msecci/Esp32_WROOM_MQTT_Terrario/documentazione/Progetto Terrario Evoluto.odt

Terrario Evoluto

Un ecosistema controllato con illuminazione intelligente

# Introduzione

Il presente documento contiene dettagli su un coperchio per terrario di ultima generazione che combina tecnologia avanzata e praticità per offrire un ambiente ottimale alle piante. Questo innovativo coperchio è dotato di un sistema di illuminazione a LED, pilotato dal modulo ESP32, che consente di gestire diverse gradazioni di luminosità. Oltre a garantire un'illuminazione personalizzabile, il coperchio è equipaggiato con sensori in grado di rilevare la temperatura e l'umidità del terrario.

Grazie alla possibilità di programmare gli accensioni e gli spegnimenti, e di regolare la luminosità in base alla luce ambientale attraverso la selezione di scenari, il coperchio assicura il mantenimento di parametri ambientali con un controllo accurato. Tutti i parametri rilevati vengono visualizzati su un display, offrendo una lettura chiara e immediata delle condizioni ambientali del terrario.

La gestione remota è resa possibile attraverso un'app dedicata, che permette di monitorare e modificare le impostazioni direttamente da smartphone o tablet. Questo coperchio per terrario rappresenta la soluzione ideale per chi desidera un ambiente controllato e perfettamente adattabile alle esigenze delle proprie piante.

# Descrizione

Il progetto prevede la realizzazione di un terrario chiuso, un sistema in grado di replicare e mantenere un microambiente autonomo e controllato. Il terrario è dotato di un tappo speciale che ospita tutta l’elettronica necessaria per la gestione dell’illuminazione e del monitoraggio ambientale. L’obiettivo è fornire un ambiente ideale per lo sviluppo di piante simulando condizioni climatiche naturali con un livello di automazione elevato. In caso di superamento della soglia critica di temperatura, il sistema spegnerà i led richiedendo il ripristino manuale.

# Obiettivo

L’idea nasce dalla necessità di creare un ecosistema autosufficiente che permetta agli utenti di osservare e interagire con un ambiente naturale controllato. Il sistema offre un’illuminazione regolabile, il monitoraggio dei parametri ambientali e la possibilità di gestione remota tramite un’app dedicata. Grazie alle diverse modalità di funzionamento e alle connessioni disponibili, il terrario garantisce una grande versatilità e facilità d’uso.

# Specifiche Tecniche

## Componenti principali

- Terrario chiuso, progettato per mantenere condizioni ambientali stabili.
- Sistema di illuminazione LED composto da tre LED di colori differenti (bianco, rosso e blu), selezionati per ottimizzare la crescita delle piante e migliorare l’effetto estetico.
- Display da 2" per visualizzare le informazioni ambientali in tempo reale.
- Sensori integrati che misurano temperatura, umidità e luminosità.
- Modulo Bluetooth e Wi-Fi per la gestione e il controllo remoto.
- App dedicata per interagire con il sistema attraverso connessione locale (Bluetooth) o remota (Internet).

## Modalità operative

- Stand-alone; il sistema funziona autonomamente senza bisogno di connessione a dispositivi esterni. I parametri sono gestiti con 3 pulsanti.
- Internet: consente la gestione remota e l’accesso a informazioni aggiuntive, come data, ora e previsioni meteo settimanali.

## Tecnologia utilizzata

- Microcontrollore ESP32-C3.
- Display Oled 2”.
- Darling per pilotaggio LED TIP120.
- Sensore temperatura e umidità DHT11.
- Sensore luminosità: fotoresistenza.
- Led bianco, rosso e blu da 3W.
- Pulsanti per la gestione delle funzioni in locale.
- Protocollo bluetooth per gestione delle funzioni senza connessione a internet.
- Protocollo MQTT per la gestione remota attraverso app.

# Funzionalità e innovazione

## Gestione dell’illuminazione

Il sistema di illuminazione è progettato per adattarsi alle esigenze del microambiente interno. I LED possono essere regolati automaticamente in base alla luce ambientale presente: se l’illuminazione naturale è sufficiente, il sistema evita di accendere i LED, ottimizzando il consumo energetico. Gli scenari disponibili sono:

- Tropicale: simula un ambiente caldo e umido con illuminazione intensa.
- Temperato: riproduce un clima moderato con illuminazione equilibrata.
- Soleggiato: simula una giornata luminosa con esposizione solare diretta.
- Scenario Custom: Permette all’utente di definire manualmente l’intensità e la durata dell’illuminazione.

Inoltre, il sistema integra un timer che regola la durata di accensione dei LED in base allo scenario selezionato, garantendo un ciclo di illuminazione coerente con le esigenze dell’ambiente interno.

## Monitoraggio ambientale avanzato

Il terrario evoluto non si limita alla regolazione della luce, ma offre anche un monitoraggio completo delle condizioni ambientali:

- Temperatura e umidità: misurati costantemente dai sensori per garantire il controllo delle condizioni ottimali.
- Luminosità: valutata per ottimizzare l’accensione dei LED.
- Visualizzazione su display: tutti i dati raccolti vengono mostrati in tempo reale sul display da 2".
- Previsioni meteo: se connesso a internet, il sistema mostra dati meteorologici aggiornati, incluse le previsioni per i prossimi 7 giorni. I dati meteo sono basati sulle coordinate ricavate dalla geolocalizzazione della connessione internet. La data e all’ora sono sincronizzate sul un server NTP. Le previsioni meteo saranno

## Interazione e connettività

Il sistema offre tre modalità operative, garantendo una grande flessibilità:

- Modalità Stand-alone: il terrario funziona autonomamente senza necessità di connessione.
- Modalità Internet: permette il controllo remoto e l’accesso a informazioni esterne, come data, ora e previsioni meteorologiche.

# Applicazioni e utilizzi

Il progetto offre numerose applicazioni pratiche, sia per il settore scientifico che per l’uso personale:

- Educazione e didattica: ideale per lo studio ed esperimenti sulla gestione di ecosistemi chiusi.
- Decorazione e hobby: un oggetto innovativo per appassionati di natura e tecnologia, perfetto per ambienti domestici e lavorativi.

# Presentazione per Maker Faire

Per la presentazione del progetto alla Maker Faire 2025, saranno preparati i seguenti materiali:

- Prototipo funzionante per una dimostrazione pratica dal vivo.
- Video esplicativo che illustra il funzionamento del sistema.
- Brochure informativa con dettagli tecnici e descrizione del progetto.

### Titolo del Progetto: Terrar0 Evoluto – Ecosistema Autonomo e Interattivo

#### Descrizione del Progetto:

Il Terrario Evoluto è un ecosistema chiuso e autosufficiente dotato di tecnologia avanzata per garantire il monitoraggio e la gestione ottimale dell’ambiente interno. Il sistema integra un tappo intelligente che fornisce illuminazione tramite LED, controlla i parametri ambientali (temperatura, umidità, illuminazione), gestisce scenari di funzionamento personalizzati e si interfaccia con un'app per il controllo remoto. Inoltre, il dispositivo è equipaggiato con un display che mostra in tempo reale i parametri ambientali e fornisce previsioni meteo, rendendo il terrario un vero e proprio punto di connessione tra natura e tecnologia.

#### Utilizzo e Destinatari:

Il errario Evoluto è pensato per appassionati di botanica, tecnologia e design, oltre che per chi desidera avere un piccolo ecosistema autosufficiente in casa, in ufficio o in ambienti didattici. Il sistema consente di osservare e interagire con un habitat naturale senza interventi quotidiani, offrendo un'esperienza educativa e decorativa allo stesso tempo.

#### Impatto del Progetto:

Grazie all’integrazione tra natura e tecnologia, il errario Evoluto rappresenta una soluzione innovativa per chi desidera avvicinarsi al mondo della coltivazione automatizzata e del monitoraggio ambientale. La possibilità di visualizzare previsioni meteo e parametri in tempo reale su un display facilita la gestione dell’ecosistema, aumentando la consapevolezza sui fattori ambientali. Il progetto ha il potenziale di diffondersi nel settore dell’interior design, della didattica e della smart home.

#### Motivazioni per Avere uno Stand a Maker Faire Rome:

Maker Faire Rome è l’evento ideale per presentare il errario Evoluto, poiché unisce innovazione, tecnologia e sostenibilità. Esporre il progetto permetterebbe ai visitatori di osservare dal vivo il funzionamento dell’ecosistema, testare le sue funzionalità interattive e comprenderne l’applicazione in diversi contesti. La sua combinazione di elettronica, software e biologia lo rende un esempio perfetto di interdisciplinarità, rispecchiando lo spirito dell'evento.

#### Stato Attuale dello Sviluppo e Prodotto Finale:

Il progetto è attualmente in fase di messa a punto del software. L’obiettivo è migliorare l’integrazione tra sensori e l’app, perfezionare il design del display per rendere la visualizzazione più fluida. Se selezionato, il errario Evoluto sarà presentato come una versione completamente funzionale, con un’interfaccia ottimizzata e la possibilità di interazione diretta con il pubblico.

Parlami di te

Ho realizzato progetti di home automation a livello hobbistico, basati sull'utilizzo di microcontrollori e app di controllo gestite con il protocollo mqtt.

Sono ingegnere informatico e nella vita lavorativa mi occupo di coordinare un gruppo di persone che si occupano dello sviluppo di applicazioni e della gestione di infrastrutture virtuali.

Nel tempo libero ho sempre coltivato la passione per lo sviluppo di progetti elettronici e sviluppo di software in generale.

Inoltre sono appassionato di retrocomputing del periodo anni 80-90.
