msecci/Esp32_WROOM_MQTT_Terrario/documentazione/video.odt

Testo per la presentazione alla Call di Maker Faire

# Versione 1 del testo per video

🎙️ VOCE NARRANTE (tono pacato, affascinato):

Musica leggera e suggestiva in sottofondo. Inquadratura iniziale su una mensola, luce naturale, diversi barattoli di vetro in primo piano.

"In un angolo silenzioso del nostro mondo moderno, esiste un ecosistema in miniatura.
Chiuso in un semplice barattolo di vetro, grande quanto una mano...
vive un frammento di natura, autosufficiente e sorprendentemente vivo."

Ripresa lenta e fluida, dolly in avanti su un barattolo di vetro da 12 cm di diametro e 20 di altezza. Zoom su felci, muschi, gocce di condensa sul vetro.

"Un terrario chiuso. Un giardino in bottiglia.
Ma non è solo una creazione estetica…
È un piccolo mondo in equilibrio, governato da una tecnologia che non si vede, ma si percepisce."

Taglio su un dettaglio: il tappo. Movimento circolare di camera che lo esplora. Taglio ravvicinato sui tre LED e display acceso.

"A renderlo speciale è lui: il tappo smart.
Un concentrato di ingegno, dove biologia e microelettronica si incontrano in armonia."

Inquadratura ravvicinata del tappo aperto: si intravede la scheda ESP32. Le luci dei LED cambiano: blu, rosso, bianco.

"Un cuore digitale, basato su ESP32, che regola con precisione le condizioni ambientali.
Tre LED – bianco, rosso e blu – simulano la luce del giorno, o ricreano quella delle albe tropicali."

Taglio su display integrato nel tappo, ben visibile. Viene mostrata l’interfaccia con temperatura, umidità, meteo settimanale.

"Sul piccolo display, come in una finestra sul futuro, appaiono i parametri vitali:
temperatura, umidità, e perfino le previsioni meteo dei prossimi sette giorni.
Una guida luminosa per il microclima racchiuso qui dentro."

Transizione su smartphone con app aperta, si vede l'interfaccia. Viene toccato un pulsante, cambia la luce nel terrario in tempo reale.

"E non finisce qui.
Grazie alla connettività MQTT, tutto può essere monitorato e controllato… da remoto, tramite app."

Inquadratura finale dall’alto: più terrari allineati, con luci diverse. Piano piano si spegne tutto tranne uno, che resta illuminato in blu tenue.

"In questi barattoli, la natura si sposa con l’ingegno.
Sono piccoli mondi… ma anche grandi idee."

Zoom lento verso il terrario acceso. Voce si abbassa lievemente.

"Ed è proprio qui che l’innovazione non fa rumore…
ma illumina la vita, goccia dopo goccia."

🎬 NOTE TECNICHE PER LE RIPRESE:

- Intro: camera slider o gimbal per movimenti fluidi su più terrari, luce naturale diffusa.
- Macro e dettagli: obiettivo macro per muschi, condensa, LED e componenti del tappo.
- Luci LED: mostrare i tre colori uno dopo l’altro, anche in combinazione.
- Display: girare più clip con dati ambientali e meteo, chiara leggibilità.
- Smartphone/app: ripresa su sfondo scuro per evidenziare il cambio di luce nel terrario.
- Finale: camera top-down o 45° inclinata per mostrare più unità, dissolvenza su terrario illuminato.

# Versione 2 del testo per video

🎙️ VOCE NARRANTE (ritmo deciso, tono tecnico ma chiaro):

Inizio con titolo su sfondo nero: “Terrario Evoluto – Tecnologia al servizio della natura”

"Questo non è un semplice terrario.
È un ecosistema chiuso, autonomo… e intelligente."

Ripresa frontale del barattolo in primo piano, illuminazione controllata. Viene ruotato lentamente su un piatto motorizzato.

"Il cuore del progetto è il tappo smart, un modulo compatto che integra elettronica di controllo, sensori e illuminazione multicanale."

Zoom sul tappo mentre viene separato dal barattolo: evidenziare struttura interna, cablaggio ordinato, scheda ESP32.

"ESP32, Wi-Fi integrato, basso consumo.
Il microcontrollore gestisce i tre LED – bianco, rosso e blu – per ricreare cicli luminosi personalizzabili."

Cut: breve demo del cambio luce RGB con timer automatico o controllo manuale.

"I parametri ambientali vengono monitorati in tempo reale:
temperatura, umidità, e condizioni esterne, con aggiornamento meteo per 7 giorni."

Ripresa del display TFT integrato: chiaro, leggibile. Cambia schermata da dati attuali a meteo settimanale.

"Tutto è visibile direttamente sul display integrato, oppure... a distanza."

Cut: smartphone con app aperta, si mostra la comunicazione via MQTT.

"Grazie al protocollo MQTT, è possibile controllare più terrari contemporaneamente da remoto, anche in scenari di automazione domestica."

Taglio su più barattoli, luci diverse, animazione dati in overlay: temperatura, umidità, stato LED.

"Il design è modulare. Il tappo è replicabile, adattabile a qualsiasi contenitore standard.
Una piattaforma ideale per esperimenti, didattica, o applicazioni IoT orientate alla sostenibilità."

Timeline rapida: stampa 3D del tappo, assemblaggio, programmazione via USB, test su banco.

"Interamente realizzato con strumenti accessibili: stampa 3D, componenti standard, librerie open source."

Finale con una panoramica di tutti i terrari accesi, ciascuno con un colore diverso e dati diversi sul display.

"il Terrario Evoluto è la dimostrazione che la tecnologia può essere invisibile, ma fondamentale.
Una piccola idea… con grandi possibilità."

Logo progetto, QR code per GitHub o sito, call to action: “Scoprilo alla Maker Faire”

🎬 NOTE TECNICHE PER IL VIDEO:

- Durata: circa 2 minuti con ritmo più rapido rispetto alla versione narrativa.
- Riprese suggerite:
  - Dettagli tecnici del tappo e dei collegamenti interni.
  - Funzionamento del display (diverse schermate).
  - LED in funzione con diverse combinazioni RGB.
  - Dimostrazione di controllo remoto tramite app MQTT.
  - Breve time-lapse di montaggio del tappo o animazione tecnica in overlay.
  - Visualizzazione multipla (più terrari attivi con dati sincronizzati).
- Overlay grafici: evidenziare dati, flussi MQTT, schema blocchi.

# Versione 3 del testo per video (meno formale)

🎙️ VOCE FUORI CAMPO (voce naturale, chiara, senza troppa enfasi)

Inquadratura iniziale su un barattolo in vetro con luce calda, poi taglio sul tappo smart.

"Questo è un terrario chiuso, ma con una particolarità:
sul tappo c’è tutta l’elettronica che serve per monitorare e controllare il suo microclima."

Ripresa del tappo smontato, si vedono scheda e componenti.

"Dentro c’è un ESP32, connesso in Wi-Fi.
Gestisce tre LED – bianco, rosso e blu – che simulano l’alternanza luce-giorno, ma volendo si possono usare anche per coltivazioni particolari."

Cut: si accendono i LED uno alla volta, poi insieme.

"Il tappo è stampato in 3D. Il formato è standard per i barattoli di Ikea 365+, nei 2 formati 1,7l e 3,3l
Dentro è montato un sensore DHT11 per temperatura e umidità, e un piccolo display a colori."

Primo piano sul display, si vede cambiare tra dati attuali e meteo.

"Il display mostra in tempo reale i parametri ambientali interni… e anche le previsioni meteo dei prossimi 7 giorni, prese via internet con geolocalizzazione IP."

Ripresa su smartphone: l’app si connette, si accende una luce nel barattolo.

"Tutto si può controllare da remoto tramite il protocollo MQTT.
E’ stata anche realizzata un’app Android per il controllo e la gestione remota."

Taglio veloce: stampa 3D, saldatura, programmazione.

"È un progetto nato per sperimentare, ma può diventare anche uno strumento didattico, oppure un oggetto da arredo smart."

Inquadratura finale su uno dei terrari acceso con luce blu, display attivo.

"Semplice, ma completo.
Tecnologia e natura… dentro un barattolo."

🎬 Suggerimenti di riprese “da maker”:

- Puoi girare tutto con un telefono o una mirrorless con cavalletto.
- Non servono effetti speciali: meglio tagli semplici, luce naturale e primo piano sui dettagli.
- Aggiungi una scritta sovrimpressa con i dati tecnici chiave durante la spiegazione (es. ESP32, MQTT, LED RGB…).
- Mostra almeno una scena con cambio di colore e una con l’app che invia un comando.
- Se possibile, includi anche un time-lapse del montaggio del tappo.

## Scaletta dettagliata (durata totale: ~2:00)

Time | Contenuto / Azione video | Audio / Narrazione
00:00–00:05 | Titolo su sfondo nero: "Terrario Evoluto– Natura + Tecnologia in un barattolo" | Musica leggera in sottofondo
00:05–00:12 | Inquadratura del barattolo completo, ben illuminato, leggero panning | "Questo è un terrario chiuso, ma con una particolarità:"
00:12–00:18 | Zoom sul tappo. Stacco: si toglie dal barattolo e si vede dentro l’elettronica | "Sul tappo c’è tutta l’elettronica che serve per monitorare e controllare il suo microclima."
00:18–00:26 | Dettaglio ESP32, LED RGB, sensore. Freccette animate o etichette in overlay | "Dentro c’è un ESP32 connesso in Wi-Fi. Gestisce tre LED: bianco, rosso e blu."
00:26–00:35 | I LED si accendono uno alla volta, poi cambiano dinamicamente | "Servono per simulare il ciclo giorno-notte, ma volendo anche per la crescita delle piante."
00:35–00:42 | Si mostra il tappo stampato in 3D, focus su file CAD e fase di stampa | "Il tappo è stampato in 3D. Il formato è standard, per barattoli twist-off da 82 mm."
00:42–00:49 | Display acceso, alterna schermate: temperatura, umidità, meteo | "Un sensore misura temperatura e umidità. Il display mostra tutto in tempo reale, insieme alle previsioni meteo."
00:49–00:58 | Smartphone con l'app, accende e spegne LED, oppure cambia scenario | "Tutto si può controllare anche da remoto tramite MQTT, io uso un’app Android che ho fatto apposta."
00:58–01:06 | Panoramica di 3-4 terrari con colori diversi e dati diversi | "Si possono controllare più terrari insieme, ognuno con la sua configurazione."
01:06–01:14 | Time-lapse veloce: stampa 3D → assemblaggio → upload sketch | "È tutto replicabile: stampa 3D, componenti standard."
01:14–01:22 | Vista da tavolo con un utente che guarda il display e l’app | "Perfetto per sperimentare, per imparare… o anche solo da tenere in casa come oggetto smart."
01:22–01:30 | Inquadratura finale su un barattolo acceso, luce soffusa, dati ben leggibili | "Tecnologia e natura… dentro un barattolo."
01:30–02:00 | Schermata finale: logo progetto, QR code GitHub o link, scritta “Progetto candidato Maker Faire” | Solo musica di sottofondo

# Presentazione tecnica (da allegare)

## 🧪 Terrario Evoluto

Microecosistema autonomo, controllato dalla tecnologia

### 🔍 Descrizione del progetto

Il Terrario Evoluto è un sistema integrato che unisce aspetto ecologico e microelettronica in un contenitore chiuso, dove il microclima che si crea con l’umidità e l’illuminazione fornita, consente il mantenimento dell’ecosistema per molto tempo senza interventi dall’esterno.
Il cuore del sistema è un tappo intelligente, stampato in 3D, che integra l’elettronica per il monitoraggio e la gestione del microclima interno, oltre alla connettività Wi-Fi per il controllo da remoto.

### 🧠 Componenti principali

- Microcontrollore ESP32 – Dual-core, Wi-Fi, Bluetooth, basso consumo
- Display a colori TFT 1.9" – Mostra temperatura, umidità, e previsioni meteo (7 giorni)
- Sensori ambientali – DHT11 e fotoresistenza: temperatura, umidità e luminosità
- LED 3W ad alta efficienza (bianco, rosso, blu) – Illuminazione simulata per cicli giorno/notte per favorire la crescita piante
- Modulo Wi-Fi + protocollo MQTT – Comunicazione real-time con app Android
- Tappo realizzato in stampa 3D – Compatibile con barattoli standard Ikea 365+ (diametro 120mm)

### 📱 Software e connettività

- Firmware personalizzato su ESP32 (Arduino/C++)
- Comunicazione MQTT per controllo e monitoraggio remoto
- App Android per visualizzazione parametri e controllo LED
- Auto-sync meteo tramite API (open-meteo.com)
- Geolocalizzazione con servizio API di ip-api.com

### 🧩 Funzionalità avanzate

- Modalità demo per esposizione: cambio ciclico RGB + info live
- Riconfigurazione via Wi-Fi (captive portal)
- Memorizzazione dei parametri

### 🧰 Tecnologie e strumenti utilizzati

- Stampa 3D FDM PLA (Struttura tappo)
- Arduino IDE /(Firmware ESP32)
- MQTT Broker (Mosquitto)
- App Inventor 2 (app android)
- Open.Meteo API (dati meteo)
- PCB prototipale / breadboard (versioni test)
- TinkerCad (design tappo)

### 🎯 Obiettivi del progetto

- Dimostrare come la tecnologia possa integrarsi in microambienti autosufficienti
- Esplorare la sinergia tra IoT, automazione ed ecologia

### 🛠️ Stato del progetto

- ✅ Hardware testato e funzionante
- ✅ Firmware in beta.
- ✅ App Android operativa
- 🔄 completamento sviluppo per: gestione timer e scenari

### 🚀 Perché portarlo alla Maker Faire

- È innovativo, educativo e replicabile
- Unisce IoT, ambiente, stampa 3D, app e automazione
- Piace a maker, educatori, appassionati di botanica e sostenibilità
- Dimostra come anche oggetti semplici possano diventare smart

### 📞 Contatti

- Progetto a cura di: Marco Lucani
- Email: terrario.evoluto@gmail.com

# Questionario Maker Faire

## Descrizione del progetto

Le informazioni richieste in questa sezione sono riservate al team Maker Faire Rome e non saranno rese pubbliche. Possono essere compilate indifferentemente in italiano o in inglese.

Descrivi il progetto.

Questa descrizione è interna e riservata al team Maker Faire Rome; non sarà resa pubblica. In questa sezione presenti il tuo progetto al team Maker Faire Rome che seleziona le proposte. Cerca di essere esaustivo e di farci capire concretamente l'oggetto che porterai nel tuo stand. Raccontaci la tua idea, il suo utilizzo, i destinatari, le caratteristiche tecniche, l’impatto che credi che il tuo progetto possa avere e cosa lo rende unico o migliore rispetto ad altri progetti simili. Ci aspettiamo che quello che descrivi qui corrisponda a ciò che porterai fisicamente in fiera.

Il Terrario Evoluto è un ecosistema chiuso e autosufficiente dotato di tecnologia avanzata per garantire il monitoraggio e la gestione ottimale dell’ambiente interno. Il sistema integra un tappo intelligente che fornisce illuminazione tramite LED, controlla i parametri ambientali (temperatura, umidità, illuminazione), gestisce scenari di funzionamento personalizzati e si interfaccia con un'app per il controllo remoto. Inoltre, il dispositivo è equipaggiato con un display che mostra in tempo reale i parametri ambientali e fornisce previsioni meteo, rendendo il terrario un vero e proprio punto di connessione tra natura e tecnologia.

E' pensato per appassionati di botanica, tecnologia e design, oltre che per chi desidera avere un piccolo ecosistema autosufficiente in casa, in ufficio o in ambienti didattici. Il sistema consente di osservare con un habitat naturale senza interventi quotidiani, offrendo un'esperienza educativa e decorativa allo stesso tempo.

Grazie all’integrazione tra natura e tecnologia, il Terrario Evoluto rappresenta una soluzione innovativa per chi desidera avvicinarsi al mondo dei terrari chiusi, mantenendone il controllo grazie alla tecnologia utilizzata. La possibilità di visualizzare previsioni meteo e parametri in tempo reale su un display facilita la gestione dell’ecosistema, aumentando la consapevolezza sui fattori ambientali. Il progetto ha il potenziale di diffondersi nel settore dell’interior design, della didattica e della smart home.

Maker Faire Rome è l’evento ideale per presentare il Terrario Evoluto, poiché unisce innovazione, tecnologia e sostenibilità. Esporre il progetto permetterebbe ai visitatori di osservare dal vivo il funzionamento dell’ecosistema, testare le sue funzionalità interattive e comprenderne l’applicazione in diversi contesti. La sua combinazione di elettronica, software e natura lo rende un esempio perfetto di interdisciplinarità, rispecchiando lo spirito dell'evento.

Il progetto è attualmente in fase di messa a punto del software. L’obiettivo è migliorare l’integrazione tra sensori e l’app, perfezionare il design del display per rendere la visualizzazione più fluida. Se selezionato, il Terrario Evoluto sarà presentato come una versione completamente funzionale, con un’interfaccia ottimizzata e la possibilità di interazione diretta con il pubblico.

Vuoi allegare un documento che aiuta ad illustrare la tua proposta?

(facoltativo)

In che stato si trova il progetto?

Indica il livello di completamento in relazione a quanto hai descritto sopra.

Complete - It already works

In progress - I will finish it before Maker Faire

In progress - I will finish it after Maker Faire

Quali sono le motivazioni della tua partecipazione?

Puoi indicare più risposte.

Showcasing my project and sharing knowledge

Creating a hands-on activity to inspire others to make

Selling at Maker Faire

Promoting a product or service

Launching a product or service

Active Networking (collecting names, signatures, etc)

Launching or soliciting support for a crowdfunding campaign

None of the above

È previsto il coinvolgimento del pubblico in attività pratiche?

Importante! Il pubblico di Maker Faire predilige gli stand in cui oltre a vedere un progetto si possono imparare delle cose o si è coinvolti in qualche attività pratica. Se prevedi di svolgere mini-workshop o far fare delle attività al pubblico, spiegalo qui sotto.

Sì

No

Questo progetto è stato esposto in una precedente edizione di Maker Faire Rome?

2013

2014

2015

2016

2017

2018

2019

2020

2021

2022

2023

2024

Questo progetto è stato esposto in altre fiere o eventi?

Se sì, indica dove e quando.

Il progetto è presentato da una startup?

Yes

No

No, but it's in our plans

Intendi vendere un prodotto al pubblico?

No

No, but I sell them on my website

No, but I will start selling them after Maker Faire

Yes, I will sell products at Maker Faire

Yes, I will take orders for my products at Maker Faire

Dimensione del progetto:

Qualora il tuo progetto non possa essere collocato su un tavolo it preghiamo di indicarci le sue dimensioni. Quanto spazio occupa? Indica larghezza/lunghezza/altezza degli oggetti che intendi esporre e ogni altro dettaglio. Se sarai selezionato faremo di tutto per dare uno spazio adeguato al materiale che intendi esporre.

E' sufficiente un tavolo. Saranno esposti alcuni terrari (3-5) delle dimensioni di 20x20 cm circa.

Inoltre occorrerà lo spazio per 2 notebook.

Richieste tecniche:

Scrivi qui tutte le esigenze particolari (potenza elettrica ecc.). Indica anche l'eventuale livello di rumorosità.

Normale alimentazione 230V e connessione WiFi per Internet.

Rischi di sicurezza:

Il progetto comporta l'uso di fiamme libere (di qualsiasi dimensione) o di sostanze chimiche potenzialmente pericolose o presenta, comunque, elementi che potrebbero potenzialmente comportare un rischio per la sicurezza delle persone?

Nessun rischio

Richieste di posizionamento:

Se vuoi essere collocato vicino ad altri espositori, indicaci i nomi. Il posizionamento degli stand all’interno dello spazio espositivo viene fatto dai curatori allo scopo di dare la giusta visibilità e il giusto contesto ad ogni espositore e offrire al pubblico un percorso comprensibile e che invogli alla scoperta. Faremo il possibile per accontentarti, se la richiesta è compatibile con le aree tematiche della manifestazione, ma non possiamo assicurarlo.

Nessuna preferenza

## Informazioni pubbliche

Queste informazioni saranno pubblicate nel nostro sito web e il nostro press team le userà per promuovere il progetto attraverso giornalisti e media partner.

Lingua di compilazione:

Puoi compilare questa scheda in italiano o in inglese a tua scelta: ci occuperemo noi di tradurre i testi usando l'intelligenza artificiale (ma avrai la possibilità di revisionarli prima della pubblicazione).

Italiano

English

Titolo del progetto:

Terrario Evoluto– un ecosistema autonomo.

Descrivi il tuo progetto in pochissime parole: (IN ITALIANO)

Un ecosistema chiuso controllato da ESP32 e sensori ambientali per luce, umidità e temperatura, accessibile via MQTT e con led controllati in PWM.

Descrivi il tuo progetto in più parole (IN ITALIANO):

(max 600 caratteri) Fai attenzione! Questo testo sarà utilizzato per presentare il tuo progetto nel nostro sito – catalogo espositori. Ci interessa dare la giusta visibilità al tuo progetto, ti chiediamo quindi di non eccedere nel numero di caratteri e rispettare le indicazioni. Tutti i campi pubblici saranno usati per sia per la promozione del progetto online e su eventuali materiali stampati sia per preparare eventuali materiali che troverai in fiera. Se inserisci più caratteri del consentito potrebbero esserci errori di stampa, il testo potrebbe essere tagliato e non vogliamo che questo accada.

Terrario Evoluto è un ecosistema vivente controllato da ESP32, sensori e attuatori intelligenti. Monitora luce, temperatura, umidità e controlla l’illuminazione tramite PWM ed è accessibile da remoto via MQTT. E’ un semplice sistema che integra tecnologia e natura: scenari con illuminazione dinamica con fading logaritmico per simulare alba e tramonto, a corredo del microcosmo vegetale presente nel terrario.

Argomenti:

Per aiutare i visitatori a trovare il tuo progetto, indica massimo 5 argomenti tra quelli elencati.

Aerospace

Agriculture & Gardening

Architecture

Art

Artificial Intelligence

Audio & Music

Bikes

Circular Economy

Crafts

Cultural Heritage

Design & Furniture

Digital Fabrication

Drones & Rovers

Educational Technology

Electronics & IoT

Energy

Fashion & Wearables

Food

Games

Health

Home Automation

Industrial Automation

Mobility

New Materials

Open Source

Pets & Animals

Photography

Projects for Kids

Retrocomputing

Robots

Science

Smart Cities

Sport

Steam Punk

Sustainability

Virtual Reality

Autore del progetto:

Indica il nome dell'autore, o degli autori, o del gruppo, così come vuoi che appaia nel catalogo degli espositori.

Marco Lucani

Cosa imparerà il pubblico visitando il tuo stand?

I visitatori di Maker Faire Rome si aspettano di scoprire e imparare. Individua fino a tre cose che potranno imparare vedendo il tuo progetto e parlando con te. Ad esempio: come usare una particolare tecnologia, o quali principi fisici sono alla base del tuo progetto, o come si può innovare nel tuo settore... Cerca di scrivere cose accattivanti che stimolino la curiosità! Le useremo per promuoverti.

1. Come controllare luce, temperatura e umidità con tecnologie IoT usando ESP32 e MQTT.
2. Come creare effetti di illuminazione realistici con fading logaritmico via PWM.
3. Come fondere natura e tecnologia in un progetto semplice ma che pensa al futuro.

Intervista

Come classificheresti il tuo progetto?

Se pensi che appartenga a più categorie, scegli la principale.

Innovative project - Progetto innovativo

Creative project - Progetto creativo

Informative project - Progetto divulgativo

Parlaci del tuo progetto. In cosa consiste?

Un terrario intelligente gestito da ESP32 che controlla in tempo reale luce, temperatura e umidità tramite sensori e attuatori PWM. Il sistema è connesso via MQTT e integrato con effetti luminosi dinamici per simulare il ciclo naturale giorno-notte. Natura e tecnologia si fondono in perfetto equilibrio.

Da dove nasce l’idea del tuo progetto? Come sei passato dall’idea alla realizzazione? Parlaci del processo di realizzazione.

L’idea è nata dal desiderio di unire tecnologia e natura, creando un ambiente controllato dove poter osservare l’equilibrio tra luce, umidità e temperatura. Ho iniziato sperimentando con l’ESP32 e sensori ambientali, per poi integrare MQTT, fading PWM per aggiungere effetti realistici. Il progetto è cresciuto con un approccio modulare: test, debug, e tanta cura nella realizzazione delle ambientazioni naturali dando il giusto perso sia al fatture estetico che a quello tecnologico. È un laboratorio vivente che cresce ogni giorno.

In che modo creatività, tecnologia, ingegno e innovazione si fondono nel tuo progetto?

Nel mio progetto, la tecnologia diventa strumento fondamentale per rendere l’ecosistema naturale, il più autonomo possibile. La sensoristica, il microcontrollore i led pilotati in PWM non solo regolano un ambiente, ma solo un ausilio importante per ciclo vitale del terrario. Il progetto è stato studiato per mantenere la massima semplicità pur garantendo delle caratteristiche importanti per l’integrazione con l’ambiente naturale che gestisce. Terrario Evoluto è un esempio tangibile di come l'innovazione possa servire a replicare i delicati equilibri naturali.

Parliamo di voi. Avete realizzato altri progetti in passato? Cosa avete studiato? Come siete diventati dei maker?

Sono un ingegnere informatico con una passione per l’elettronica. Ho iniziato sperimentando con microcontrollori come Arduino ed ESP32, integrando software, sensori e attuatori per sviluppare soluzioni di automazione domestica. Mi appassiona trasformare idee in sistemi dove la tecnologia diventa uno strumento concreto per semplificare la vita e risolvere problemi reali.

Contatti

Sito web (questa informazione sarà pubblica):

Inserisci il link al Sito web del progetto, alla galleria di foto, al portfolio

Public e-mail: (questa informazione sarà resa pubblica)

Inserisci, se vuoi, un indirizzo mail da rendere pubblico sul catalogo espositori per farti contattare dagli utenti interessati al tuo progetto.

Terrario.evoluto@gmail.com

Public phone: (questa informazione sarà resa pubblica)

Inserisci, se vuoi, un numero di telefono da rendere pubblico sul catalogo espositori per farti contattare dagli utenti interessati al tuo progetto.

Social

Indica, se vuoi, gli account social del progetto o dell'autore del progetto.

Instagram:

Linkedin:

YouTube:

Facebook:

X (Twitter):

## Foto/video

Foto dell'autore / degli autori del progetto:

Carica una foto professionale, che potremo rendere pubblica sui nostri canali. Assicurati di avere i diritti sull'immagine che stai caricando. (Max 6MB)

Foto del progetto (1)

Puoi caricare fino a 10 foto ad alta risoluzione (saranno usate per il sito web e divulgate dall'ufficio stampa attraverso giornalisti e media partners). Formato JPG, minimo 2000px, massimo 6MB. Allega solo fotografie del progetto e non allegare render, altrimenti penseremo che il tuo progetto non sia realizzato!

Foto del progetto (2)

Foto del progetto (3):

Foto del progetto (4):

Foto del progetto (5):

Foto del progetto (6):

Foto del progetto (7):

Foto del progetto (8):

Foto del progetto (9):

Foto del progetto (10):

Link al video:

Vuoi condividere un video di presentazione del progetto? Puoi inserire un link a YouTube o Vimeo. Il video dovrebbe durare massimo 120 secondi. Se il tuo progetto sarà selezionato Maker Faire Rome potrà utilizzare il video sui propri canali per promuovere il progetto. Assicurati di possedere i diritti del video e non usare sottofondo musicale protetto da copyright.
