msecci/Esp32_WROOM_MQTT_Terrario/documentazione/Disegno.jpg

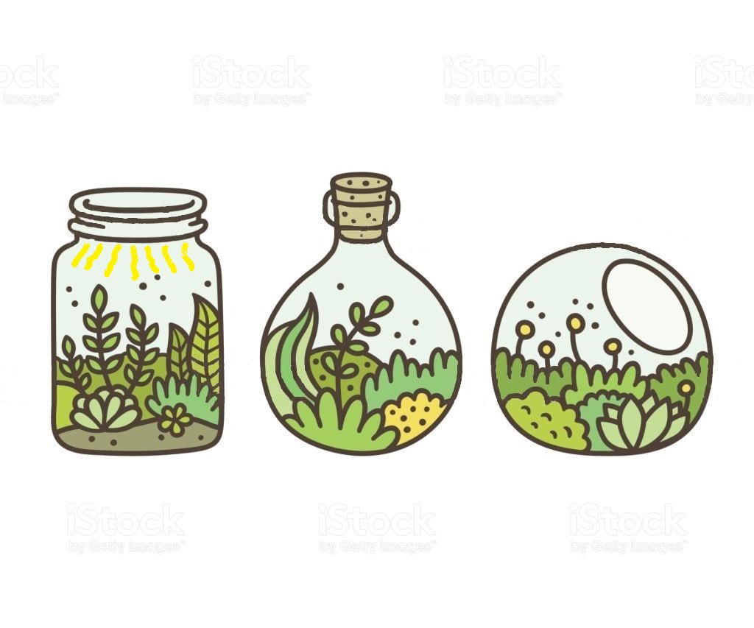
documentazione/Disegno.jpg
