msecci/Esp32_WROOM_MQTT_Terrario/documentazione/Esp32-C3-mini.png

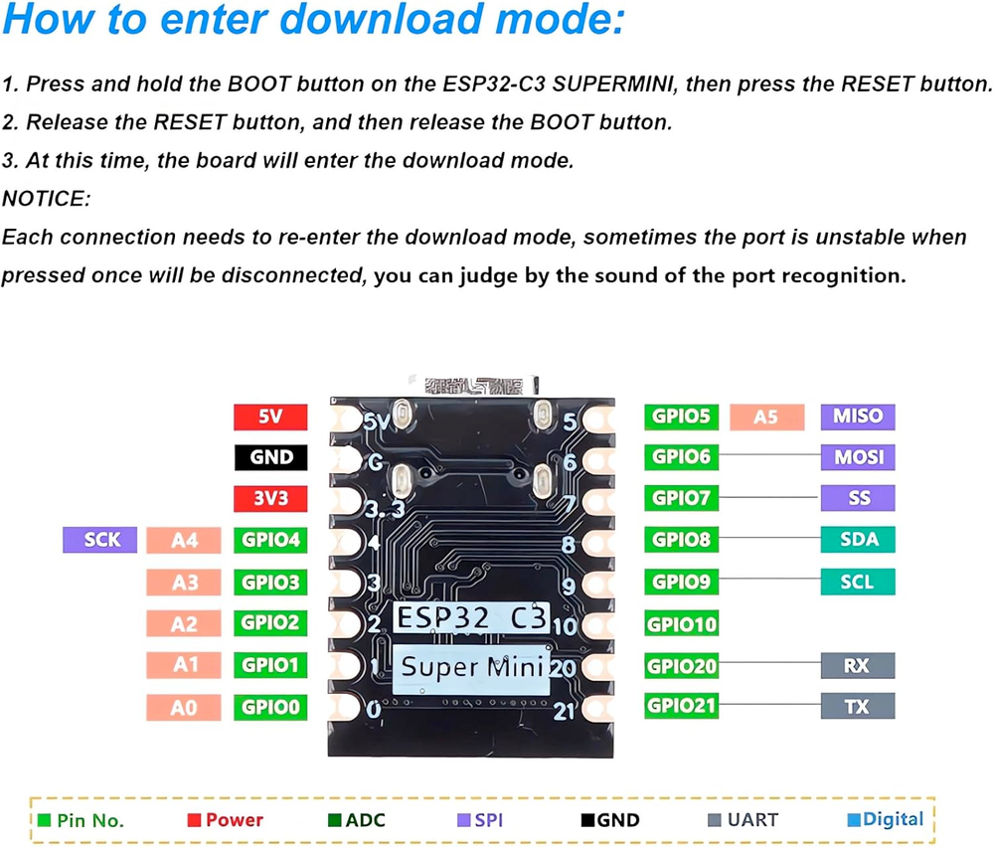
documentazione/Esp32-C3-mini.png
