msecci/Esp32_WROOM_MQTT_Terrario/documentazione/I2C-OLED-Display-Module-Pinout.jpg

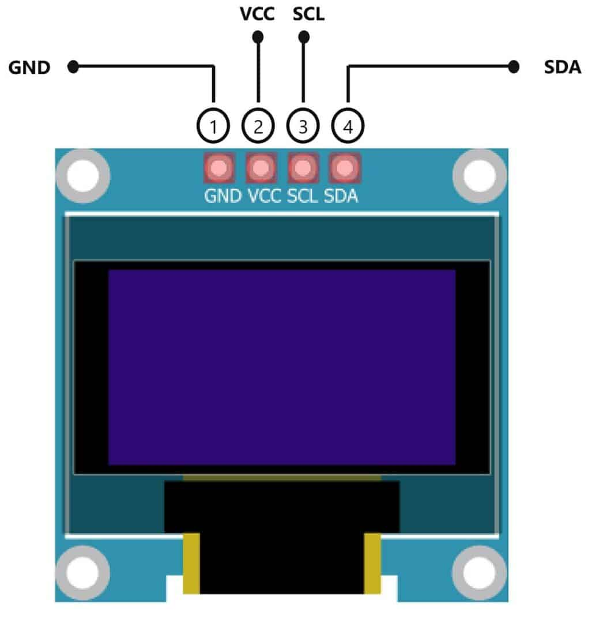
documentazione/I2C-OLED-Display-Module-Pinout.jpg
