msecci/Esp32_WROOM_MQTT_Terrario/STL/fermo.stl

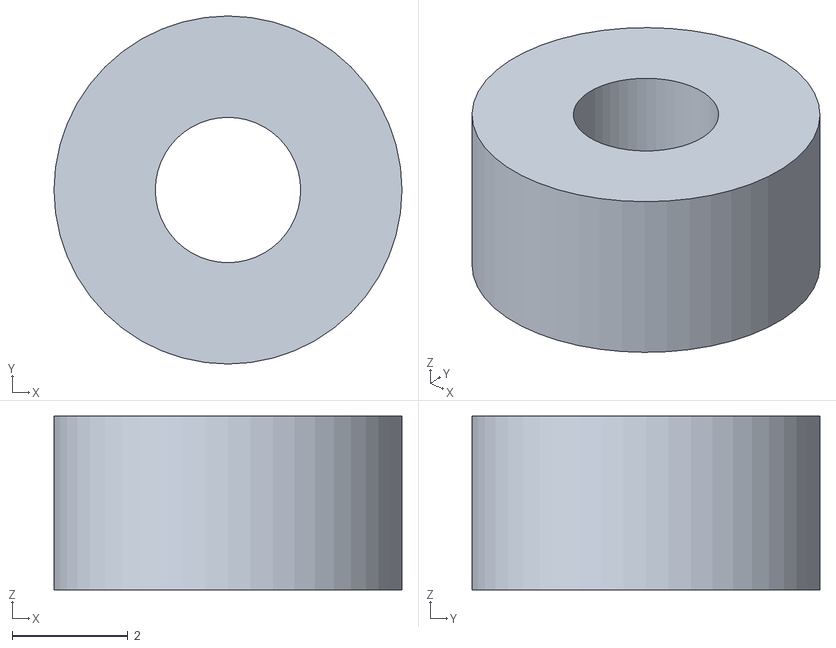
[picture p13: CAD file, 2025-10-18]
STL/fermo.stl
6.00 x 6.00 x 3.00
