msecci/Esp32_WROOM_MQTT_Terrario/STL/Fondo definitivo.stl

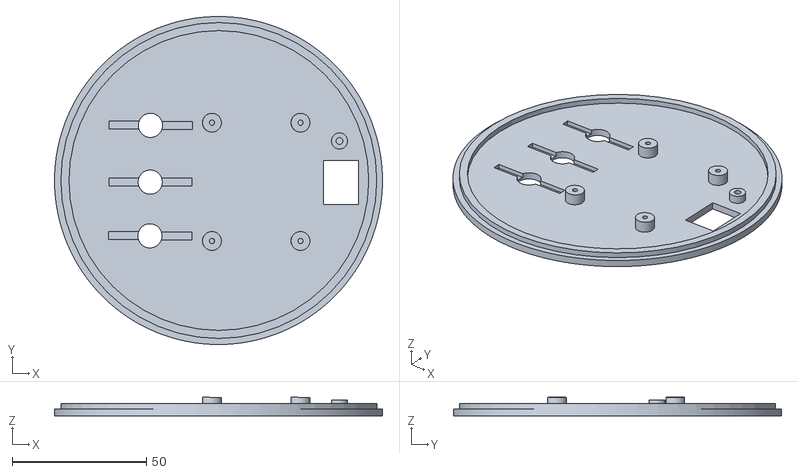
[picture p14: CAD file, 2025-10-18]
STL/Fondo definitivo.stl
122.0 x 122.0 x 7.00
