msecci/Esp32_WROOM_MQTT_Terrario/STL/Laterale superiore.stl

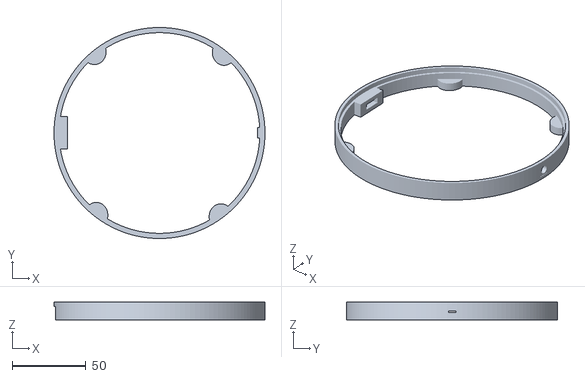
[picture p15: CAD file, 2025-10-18]
STL/Laterale superiore.stl
143.0 x 143.0 x 12.0
