msecci/Esp32_WROOM_MQTT_Terrario/STL/Coperchio.stl

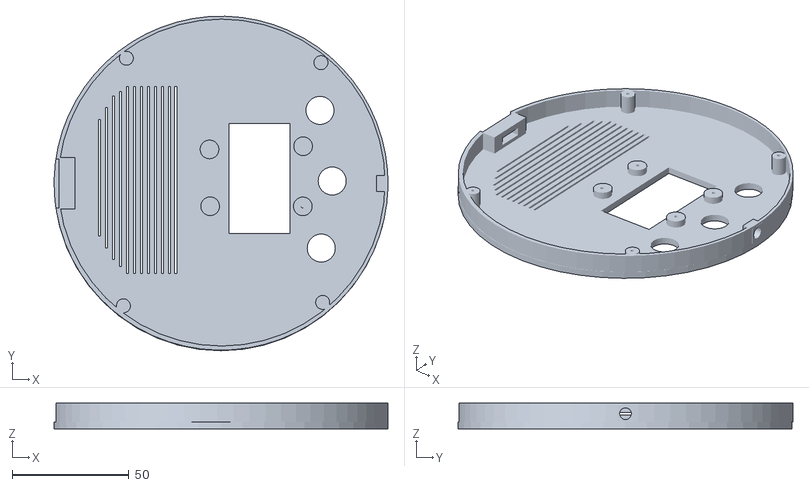
[picture p16: CAD file, 2025-10-18]
STL/Coperchio.stl
143.0 x 143.3 x 11.0
