msecci/Esp32_WROOM_MQTT_Terrario/STL/Staffetta.stl

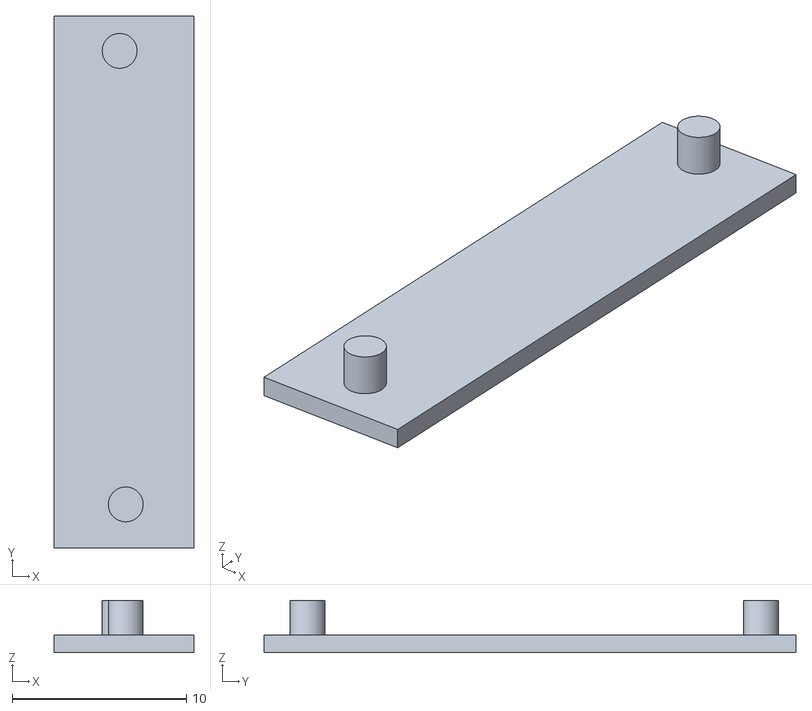
[picture p17: CAD file, 2025-10-18]
STL/Staffetta.stl
8.00 x 30.5 x 3.00
