msecci/Esp32_WROOM_MQTT_Terrario/STL/Laterale.stl

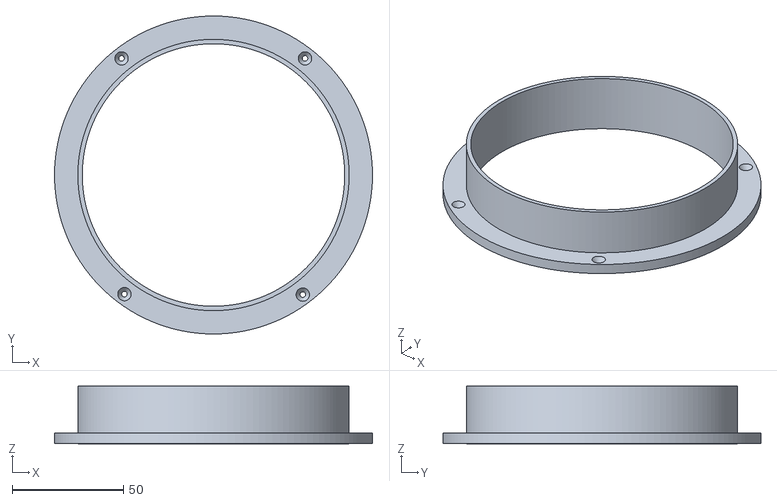
[picture p18: CAD file, 2025-10-18]
STL/Laterale.stl
143.0 x 143.0 x 26.0
