msecci/Esp32_WROOM_MQTT_Terrario/Doc maker/App-main.jpg

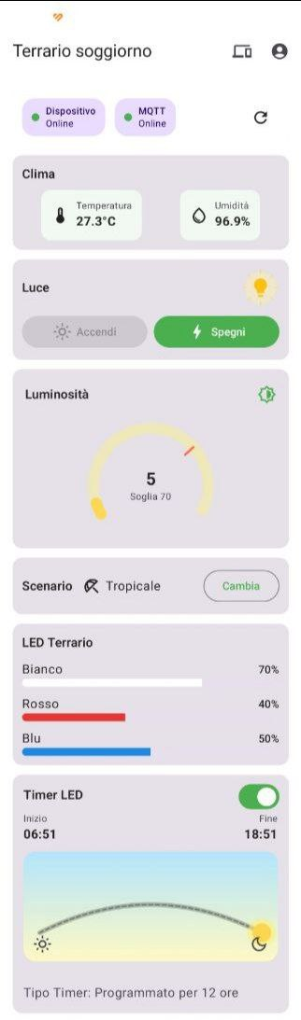
Doc maker/App-main.jpg
