msecci/Esp32_WROOM_MQTT_Terrario/Doc maker/App-setup.jpg

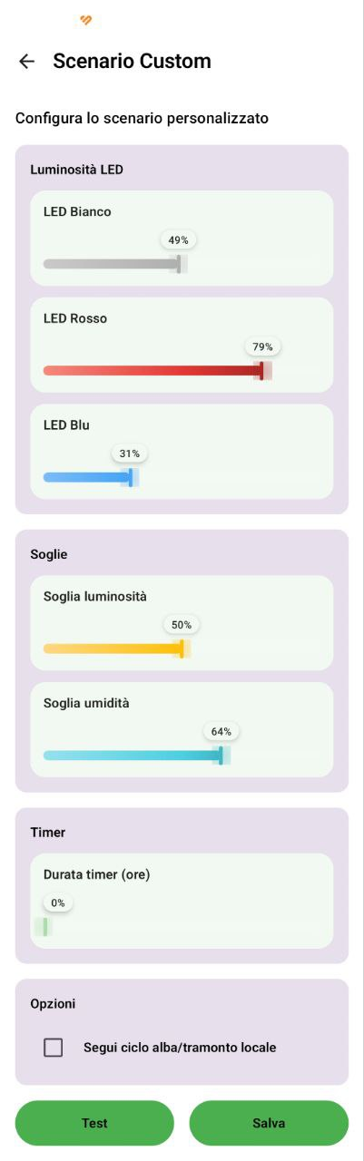
Doc maker/App-setup.jpg
