msecci/Esp32_WROOM_MQTT_Terrario/Doc maker/Display-main-new.jpg

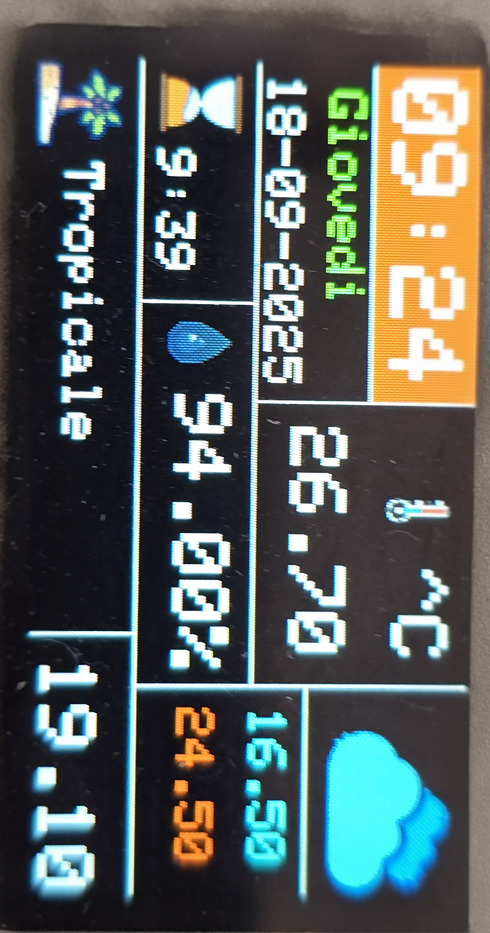
Doc maker/Display-main-new.jpg
