msecci/Esp32_WROOM_MQTT_Terrario/Doc maker/Display-main.jpg

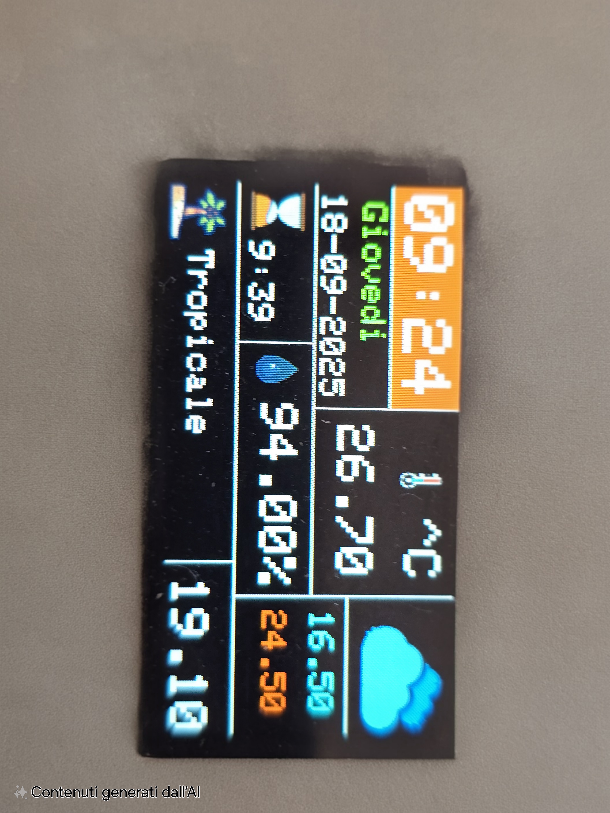
Doc maker/Display-main.jpg
