msecci/Esp32_WROOM_MQTT_Terrario/Doc maker/Display-meteo-new.jpg

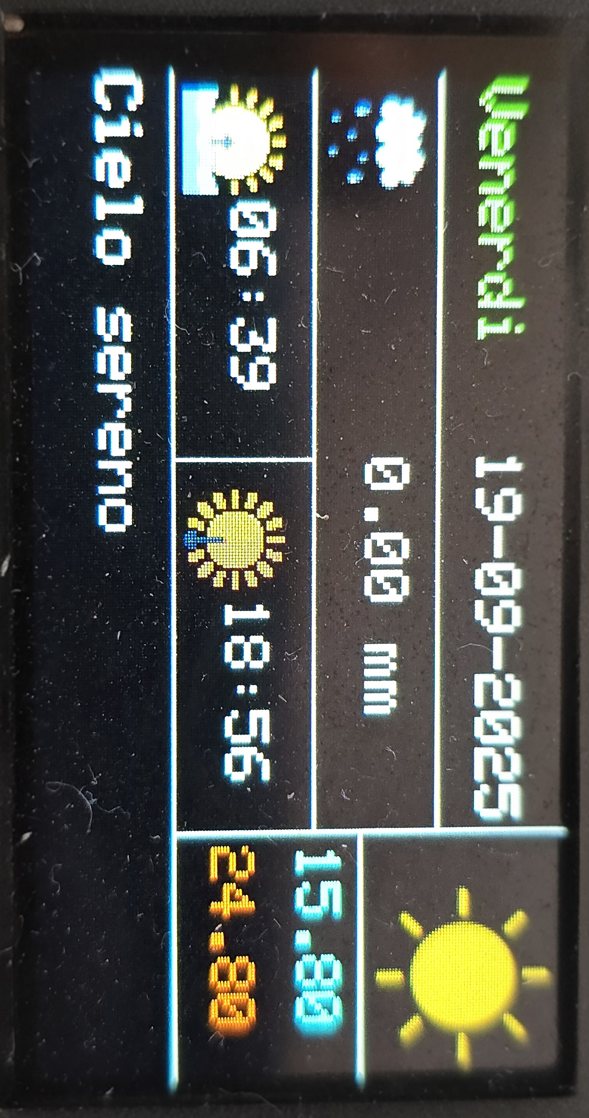
Doc maker/Display-meteo-new.jpg
