msecci/Esp32_WROOM_MQTT_Terrario/Doc maker/Terrario.jpg

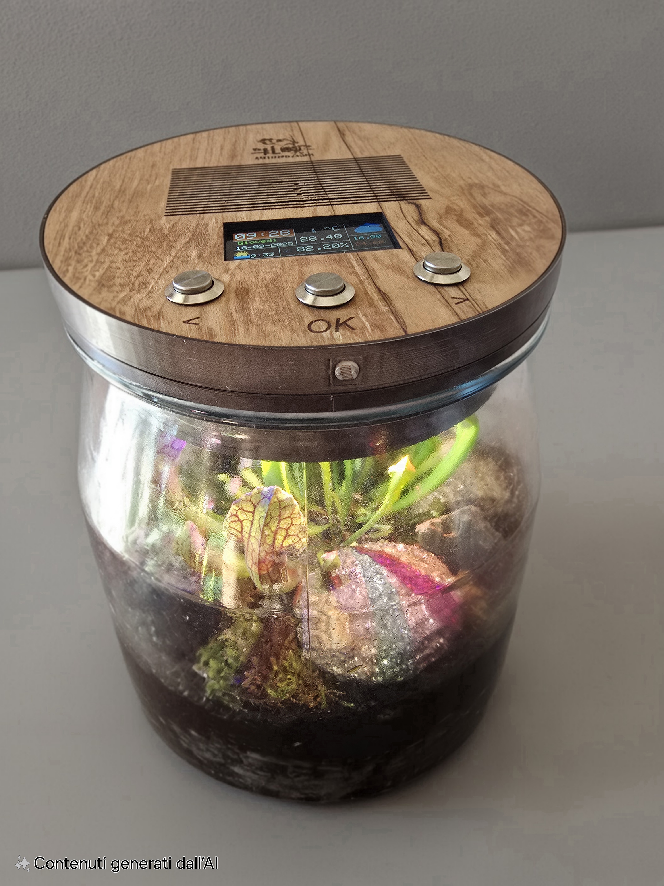
Doc maker/Terrario.jpg
