msecci/Esp32_WROOM_MQTT_Terrario/Doc maker/Terrario/20250918_092513(1).jpg

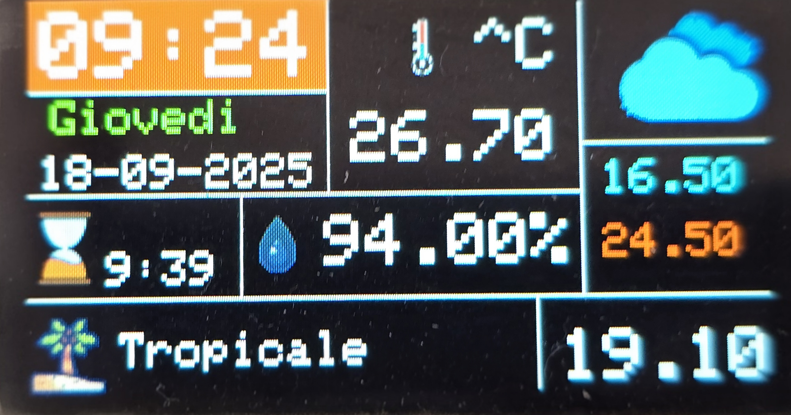
Doc maker/Terrario/20250918_092513(1).jpg
