msecci/Esp32_WROOM_MQTT_Terrario/Doc maker/Terrario/1000034960.jpg

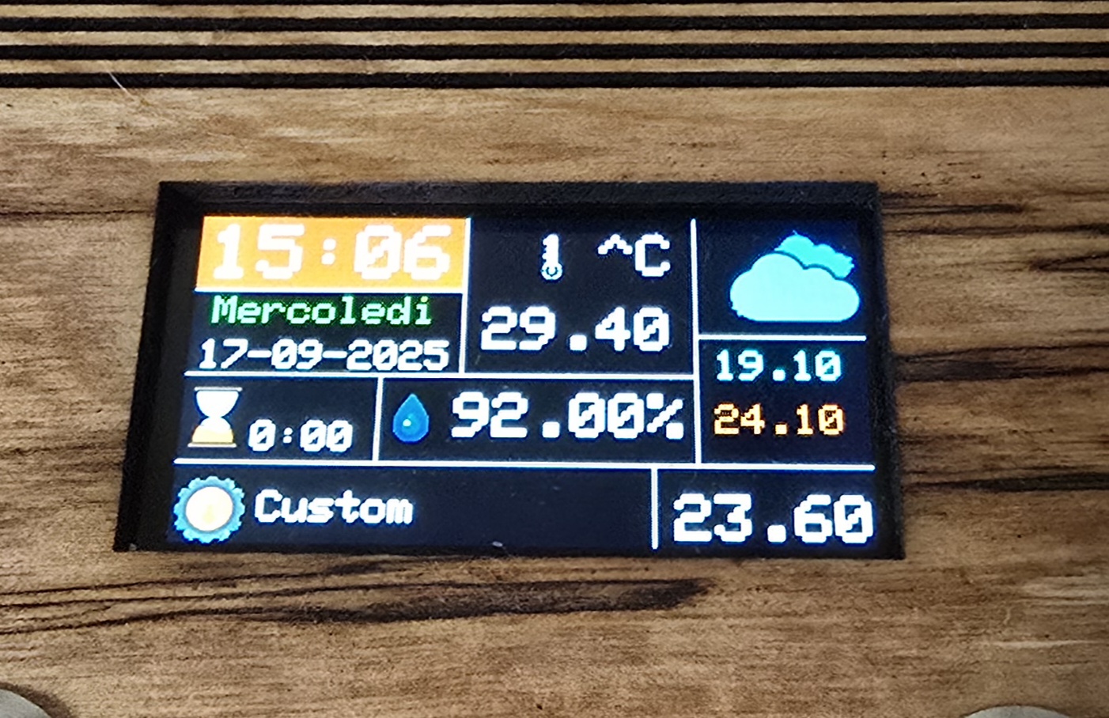
Doc maker/Terrario/1000034960.jpg
