msecci/Esp32_WROOM_MQTT_Terrario/Doc maker/Terrario/1000034961.jpg

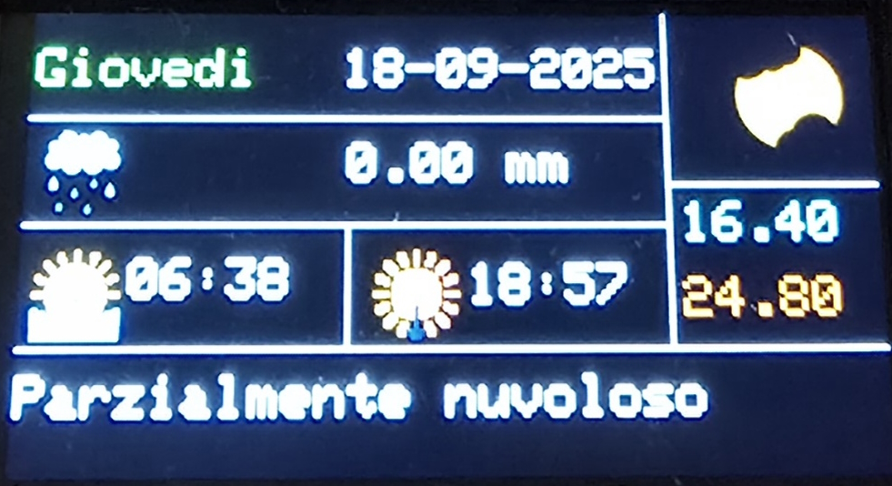
Doc maker/Terrario/1000034961.jpg
