msecci/Esp32_WROOM_MQTT_Terrario/Doc maker/Terrario/-5940794486496020601_121.jpg

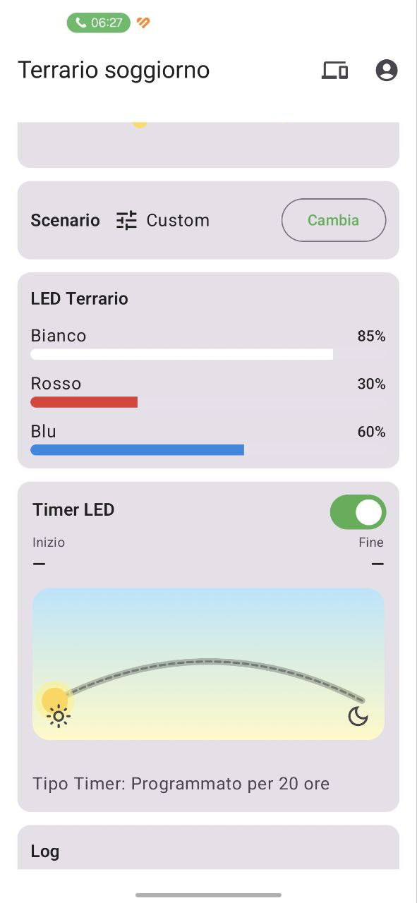
Doc maker/Terrario/-5940794486496020601_121.jpg
