msecci/Esp32_WROOM_MQTT_Terrario/Doc maker/Terrario/Coperchio.jpg

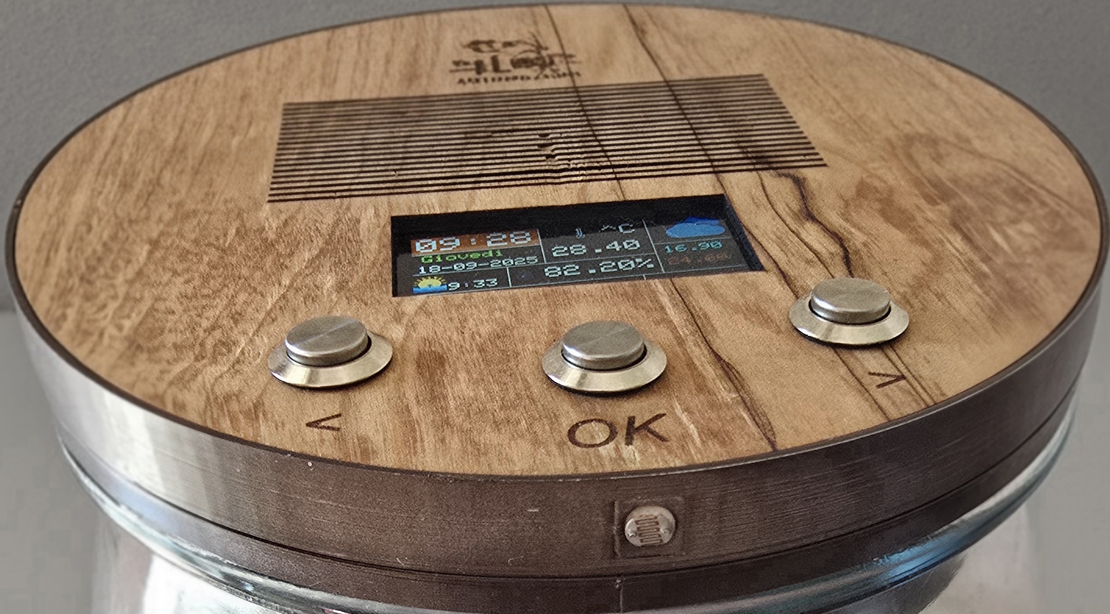
Doc maker/Terrario/Coperchio.jpg
