msecci/Esp32_WROOM_MQTT_Terrario/Doc maker/Terrario/MainScreen.jpg

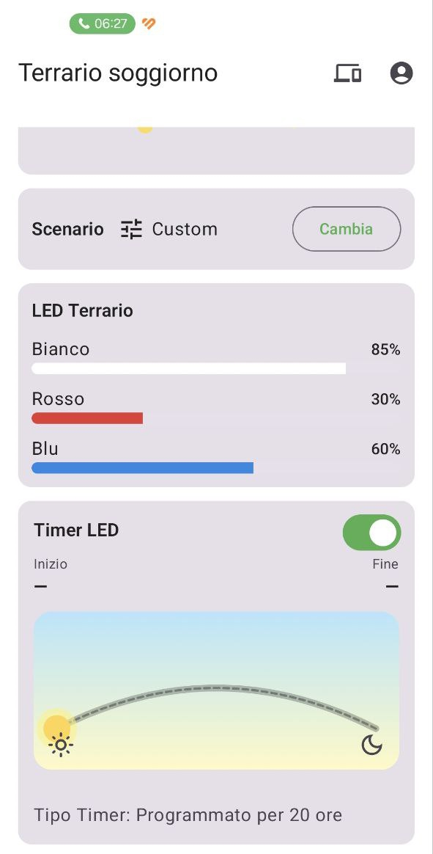
Doc maker/Terrario/MainScreen.jpg
