msecci/Esp32_WROOM_MQTT_Terrario/Doc maker/Terrario/seo-web.png

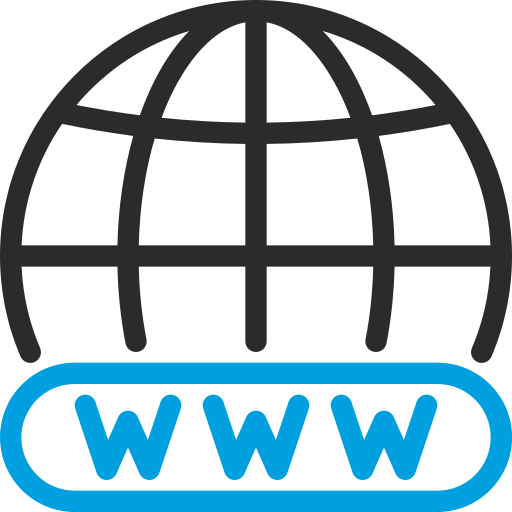
Doc maker/Terrario/seo-web.png
