msecci/Esp32_WROOM_MQTT_Terrario/Doc maker/Terrario/website_colore.png

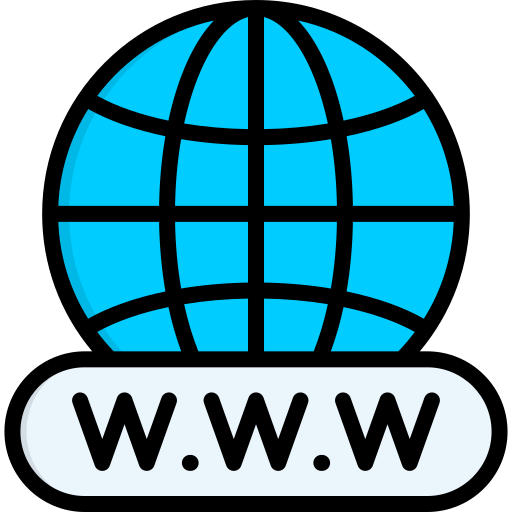
Doc maker/Terrario/website_colore.png
