msecci/Esp32_WROOM_MQTT_Terrario/documentazione/Esp32.pdf

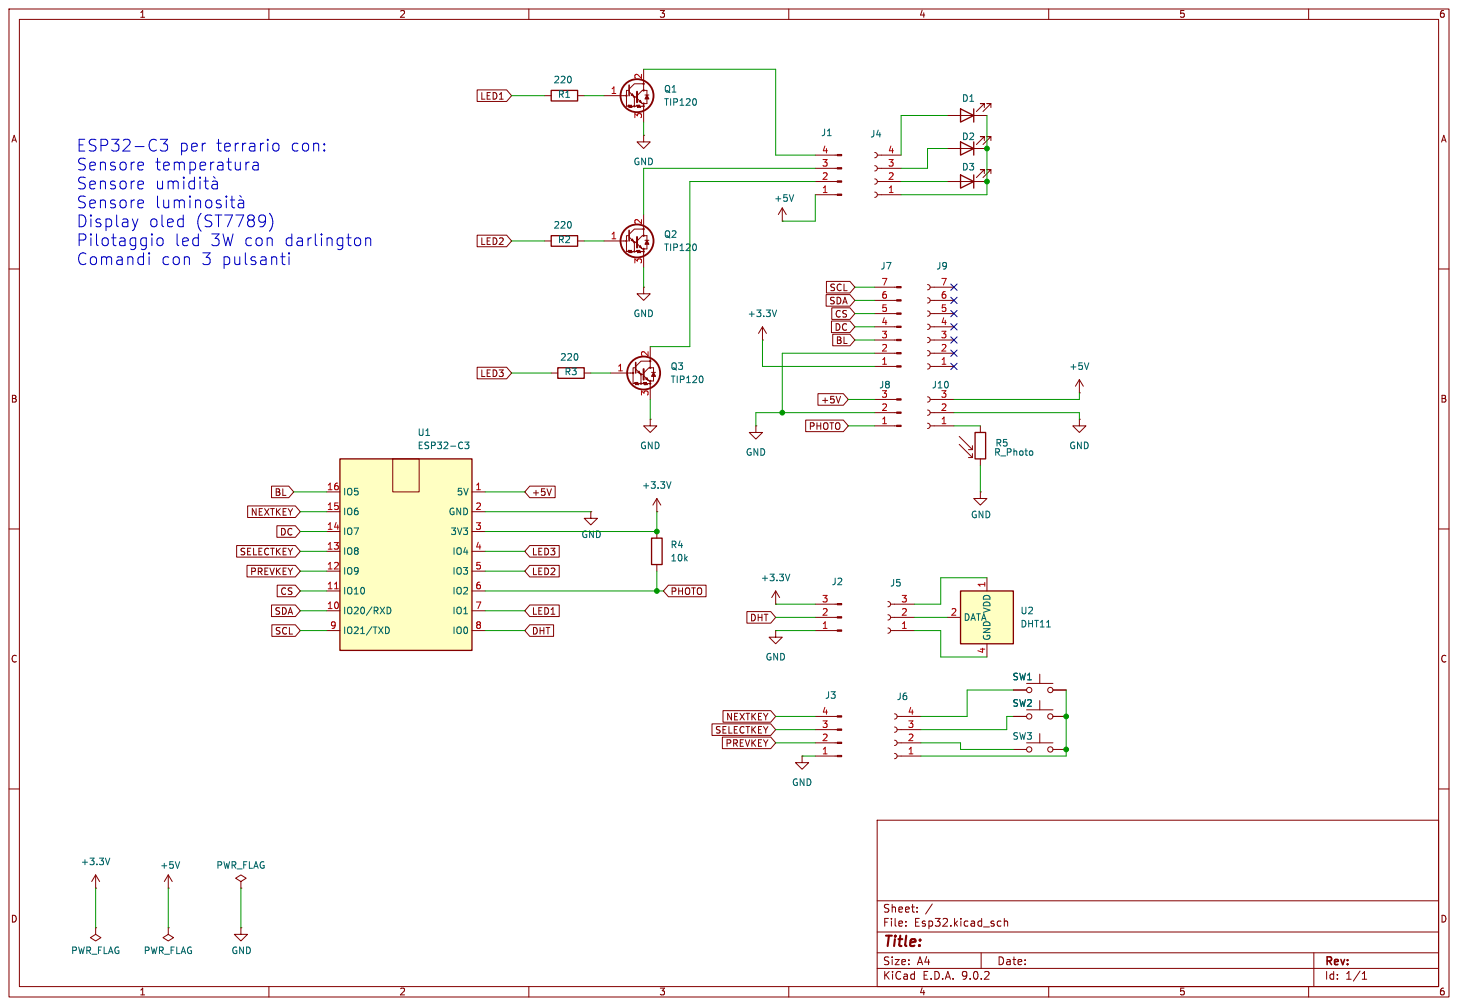
[picture p33: page 1]

LED1 DHT BL NEXTKEY DC
