msecci/Esp32_WROOM_MQTT_Terrario/Kicad/schema.pdf

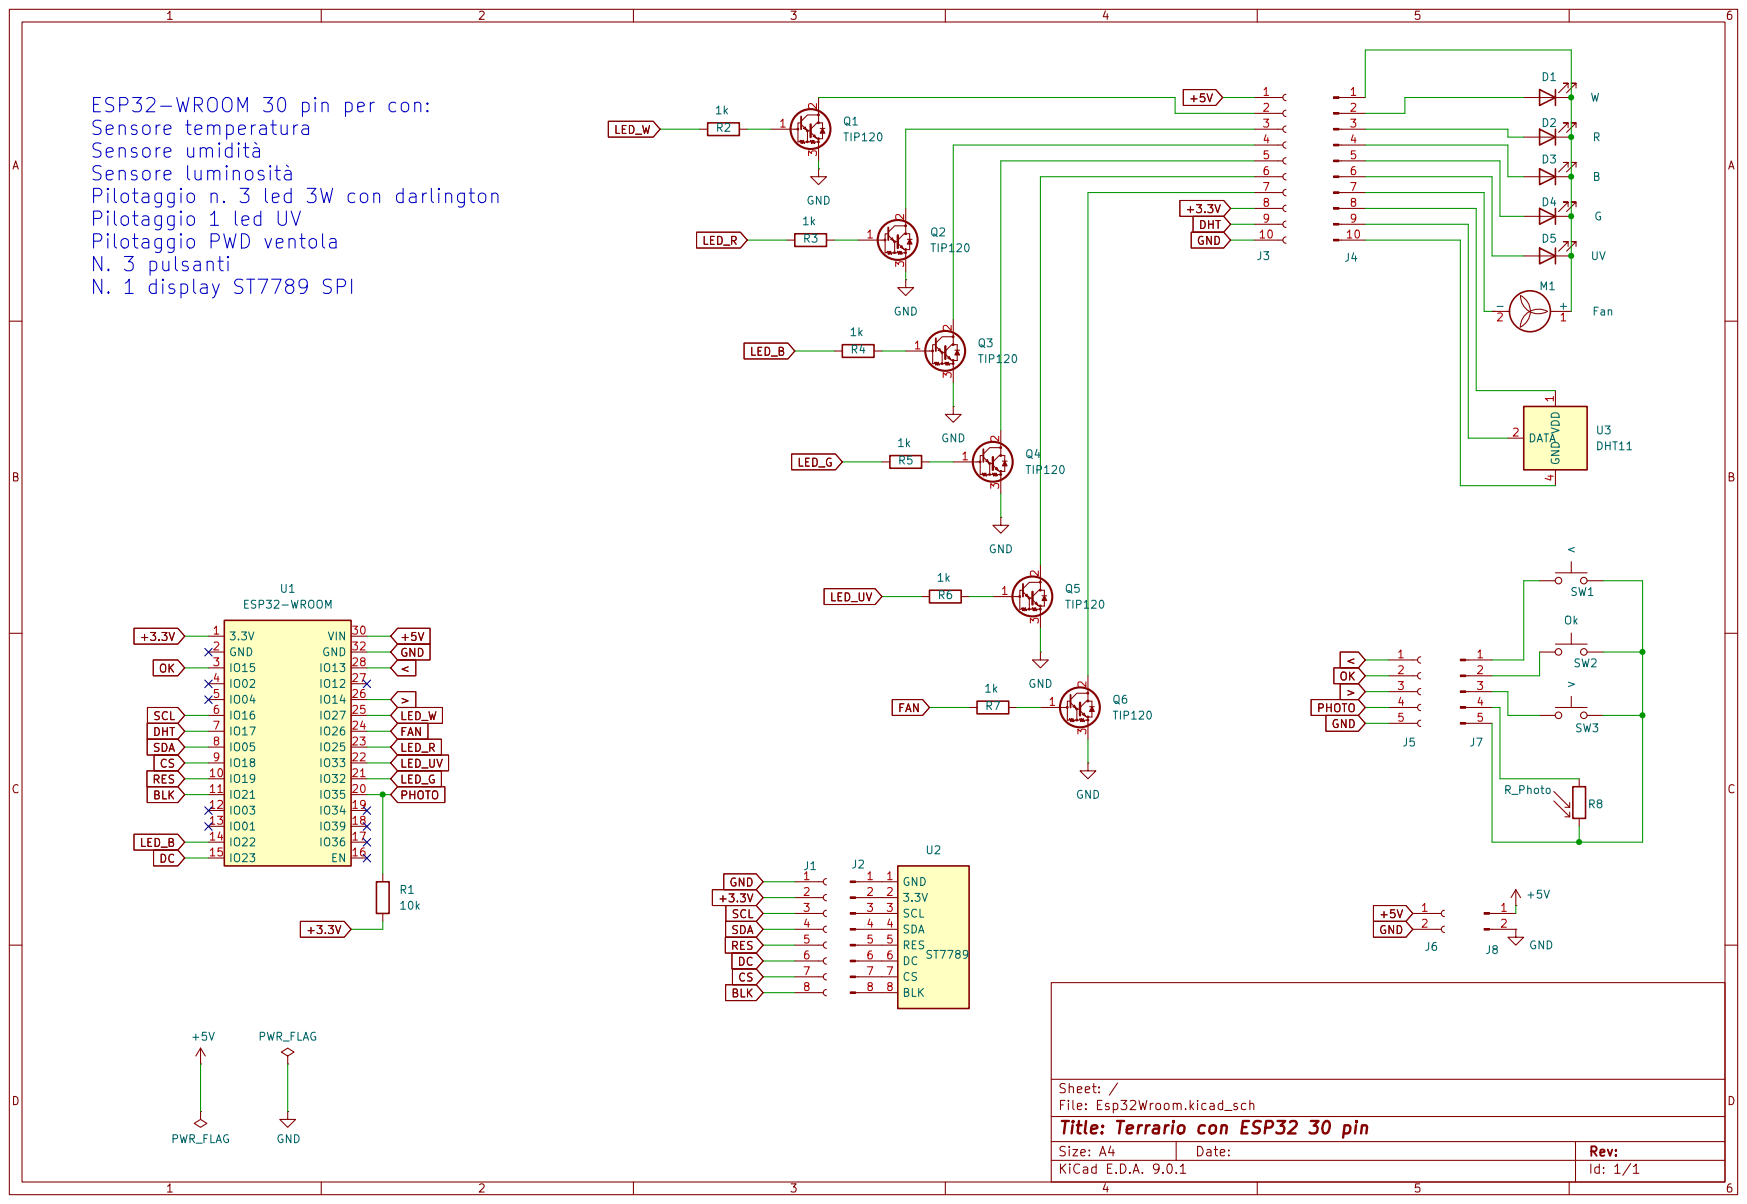
[picture p34: page 1]
