msecci/Esp32_WROOM_MQTT_Terrario/Kicad/Esp32Wroom.kicad_pcb

## KiCad design Kicad/Esp32Wroom.kicad_pcb (2025-10-18)

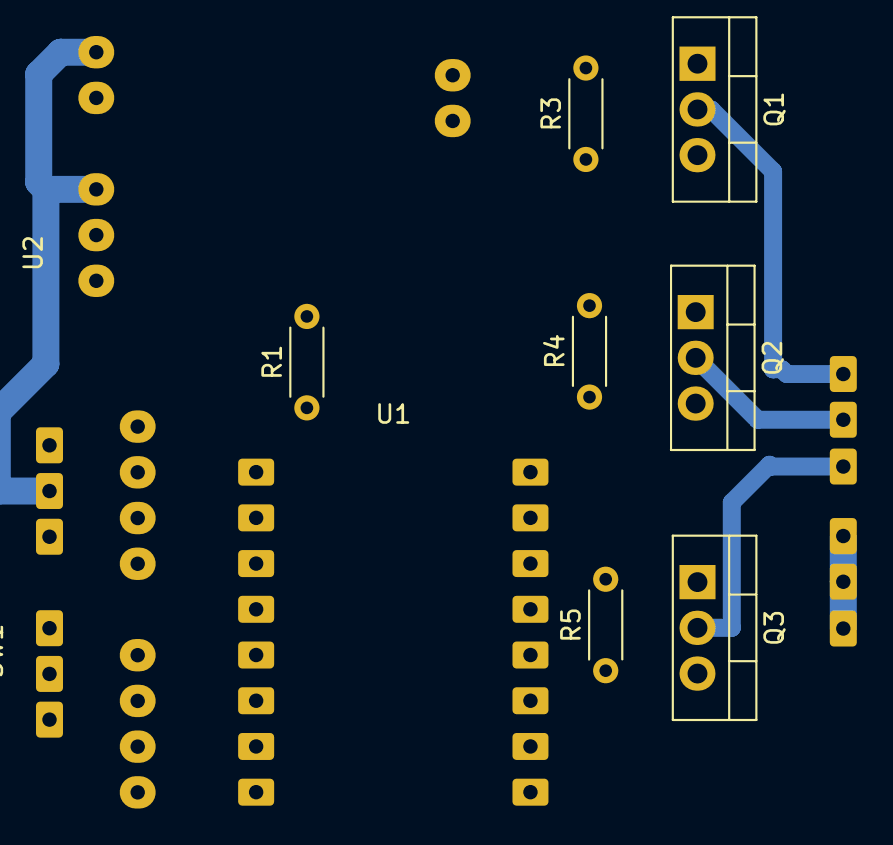
[picture p35: board Esp32Wroom.kicad_pcb from above]

Board: 2 copper layers, 10 parts (0 on the bottom side), 10 nets.

Parts:
Q1, Q2, Q3: TIP120; TO-220-3_Vertical
R1: 10k; R_Axial_DIN0204_L3.6mm_D1.6mm_P5.08mm_Horizontal
R3, R4, R5: 220; R_Axial_DIN0204_L3.6mm_D1.6mm_P5.08mm_Horizontal
SW1: SW_DIP_SPSTx02_Piano_10.8x6.64mm_W7.62mm_P2.54mm
U1: ESP32-C3; ESP32-C3-WROOM-02U
U2: DHT11; Aosong_DHT11_5.5x12.0_P2.54mm

Connections:
GNDREF: Q1.3 (E), Q2.3 (E), Q3.3 (E), SW1.GNDREF, U1.GND, U2.GDNREF, U2.GNDREF
LED1: R3.1, U1.GPI01
LED2: R4.1, U1.GPI04
LED3: R5.1, U1.GPI03
NEXTKEY: SW1.SW3, U1.GPI08
unnamed: Q1.1 (B), R3.2
unnamed: Q2.1 (B), R4.2
unnamed: Q3.1 (B), R5.2
PREVKEY: SW1.SW2, U1.GPI09
SELECTKEY: SW1.SW1, U1.GPI06
