msecci/Esp32_WROOM_MQTT_Terrario/Icone32.h

/*Codice WMO	Descrizione	Icona/Simbolo
0	Cielo sereno	☀️
1	Principalmente sereno	🌤️
2	Parzialmente nuvoloso	⛅
3	Coperto	☁️
45	Nebbia	🌫️
48	Nebbia con brina	🌫️❄️
51	Pioviggine leggera	🌧️
53	Pioviggine moderata	🌧️
55	Pioviggine intensa	🌧️
56	Pioviggine gelata leggera	🌧️❄️
57	Pioviggine gelata intensa	🌧️❄️
61	Pioggia leggera	🌧️
63	Pioggia moderata	🌧️
65	Pioggia intensa	🌧️
66	Pioggia gelata leggera	🌧️❄️
67	Pioggia gelata intensa	🌧️❄️
71	Neve leggera	🌨️
73	Neve moderata	🌨️
75	Neve intensa	🌨️
77	Granelli di neve	🌨️
80	Rovesci di pioggia leggeri	🌧️
81	Rovesci di pioggia moderati	🌧️
82	Rovesci di pioggia violenti	🌧️
85	Rovesci di neve leggeri	🌨️
86	Rovesci di neve intensi	🌨️
95	Temporale leggero o moderato	⛈️
96	Temporale con leggera grandine	⛈️🌨️
99	Temporale con forte grandine	⛈️🌨️
*/

// Icona non disponibile
const uint16_t icoNonDisponibile32[] PROGMEM  = {
   0x0000, 0x0000, 0x0000, 0x0000, 0x0000, 0x28c1, 0x30e2, 0x30e2, 0x30e2, 0x30e2, 0x30e2, 0x30e2, 0x30e2, 0x30e2, 0x30e2, 0x30e2, 0x30e2, 0x30e2, 0x30e2, 0x30e2, 0x30e2, 0x30e2, 0x30e2, 0x30e2, 0x30e2, 0x30e2, 0x28c1, 0x0000, 0x0000, 0x0000, 0x0000, 0x0000, 
  0x0000, 0x0000, 0x0000, 0x0000, 0x28c2, 0xcbc9, 0xcbc9, 0xcbc9, 0xcbc9, 0xcbc9, 0xcbc9, 0xcbc9, 0xcbc9, 0xcbc9, 0xcbc9, 0xcbc9, 0xcbc9, 0xcbc9, 0xcbc9, 0xcbc9, 0xcbc9, 0xcbc9, 0xcbc9, 0xcbc9, 0xcbc9, 0xcbc9, 0xcbc9, 0x28c2, 0x0000, 0x0000, 0x0000, 0x0000, 
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
  0x0000, 0x0000, 0x0000, 0x0000, 0x0000, 0x0000, 0x0000, 0x0000, 0x0000, 0x0000, 0x0000, 0x0000, 0x0000, 0x0000, 0x0000, 0x0000, 0x0000, 0x0000, 0x0000, 0x0000, 0x0000, 0x0000, 0x0000, 0x0000, 0x0000, 0x0000, 0x0000, 0x0000, 0x0000, 0x0000, 0x0000, 0x0000
};
