msecci/Esp32_WROOM_MQTT_Terrario/(commit log)

2025-10-18 Inizializzazione repository
    [BOM.ods, Coperchio.stl, Esp32.kicad_pcb, Esp32.kicad_sch, Esp32Mac.kicad_pcb, Esp32Mac.kicad_sch, Fondo definitivo.stl, Icone.ods]
2025-10-19 Aggiornati pin
2025-10-19 aggiornato kicad
    [Esp32Wroom.kicad_pcb, Esp32Wroom.kicad_sch]
2025-10-21 Replace Adafruit text bounds calls with TFT_eSPI equivalents
    [Esp32_WROOM_MQTT_Terrario.ino, F_Display.ino, Setup.ino]
